Avdhoot87/Summer_Research_Internship_IITGN/README.md

# DESIGN_AND_DEVELOPMENT_OF_A_PORTABLE_UNIVERSAL_TESTING_MACHINE
