Avdhoot87/Summer_Research_Internship_IITGN/CAD MODEL FINAL DESIGN/UTM FINAL MODEL.step

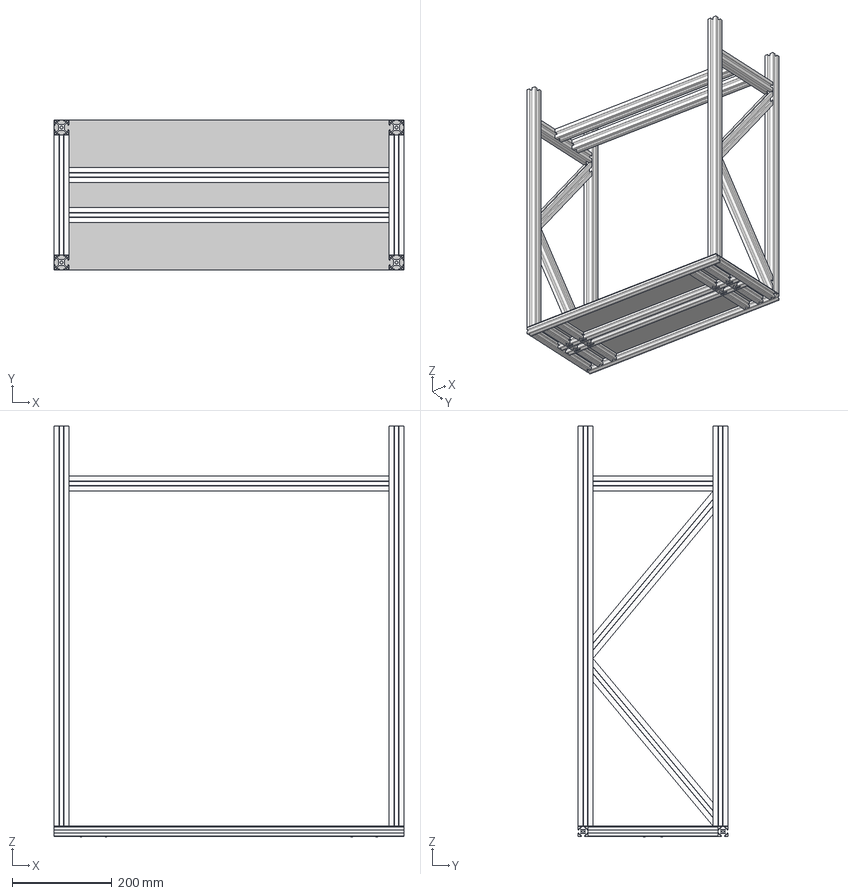
[picture p13: CAD file, 2026-09-14]
CAD MODEL FINAL DESIGN/UTM FINAL MODEL.step
700.0 x 300.0 x 822.0 mm
Steel Sheet
20 mm ROD 700 mm length x 2
20 mm ROD 260mm length x 6
20 mm ROD 660mm length x 2
800 mm Rod x 4
30x30 sketch x 2
640mm Rod x 2
KSHAPE+ROD x 4
