Avdhoot87/Summer_Research_Internship_IITGN/CAD MODEL FINAL DESIGN/UTM PARTS/LOAD CELL v1.step

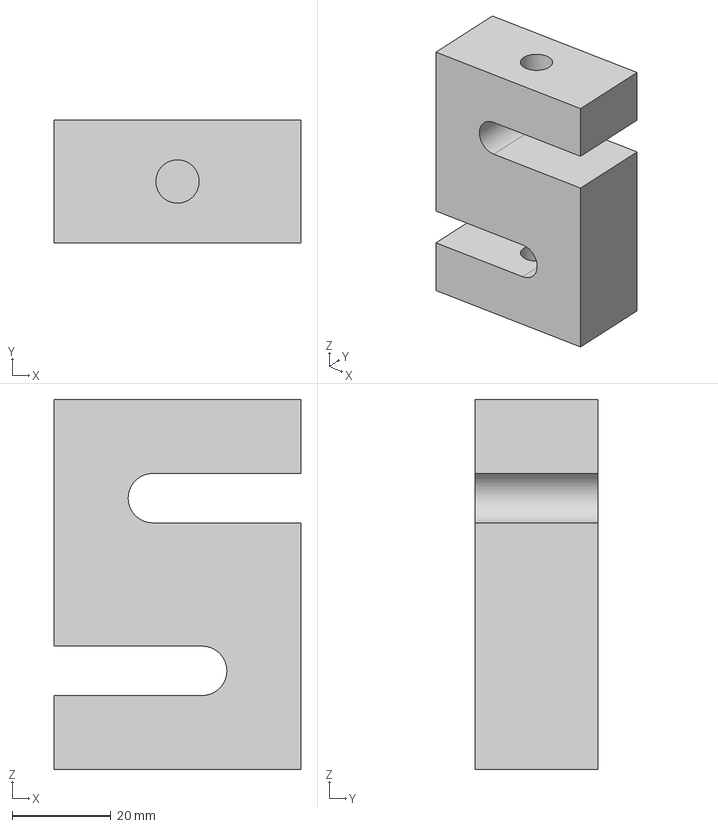
[picture p14: CAD file, 2026-09-14]
CAD MODEL FINAL DESIGN/UTM PARTS/LOAD CELL v1.step
50.0 x 25.0 x 75.0 mm
