Avdhoot87/Summer_Research_Internship_IITGN/CAD MODEL FINAL DESIGN/UTM PARTS/KSHAPE+ROD v1.step

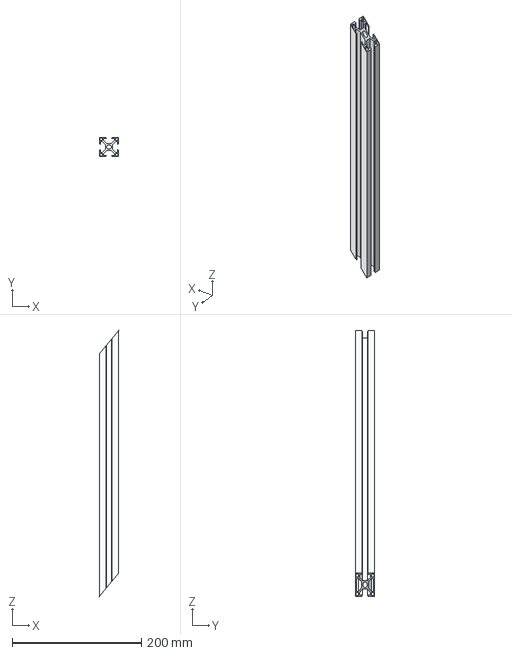
[picture p15: CAD file, 2026-09-14]
CAD MODEL FINAL DESIGN/UTM PARTS/KSHAPE+ROD v1.step
30.0 x 30.0 x 411.0 mm
