Avdhoot87/Summer_Research_Internship_IITGN/CAD MODEL FINAL DESIGN/UTM PARTS/Moving Crosshead along with load cell and load applier v1.step

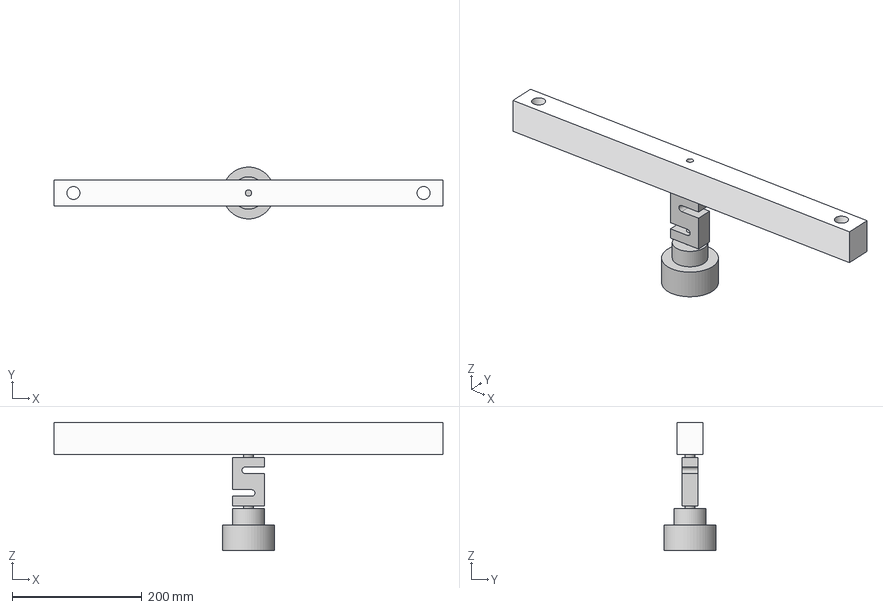
[picture p16: CAD file, 2026-09-14]
CAD MODEL FINAL DESIGN/UTM PARTS/Moving Crosshead along with load cell and load applier v1.step
600.0 x 80.0 x 198.0 mm
A_movecross
LOAD CELL JOINT NUT x 2
LOAD CELL_1
LOAD APPLIER
