Avdhoot87/Summer_Research_Internship_IITGN/CAD MODEL FINAL DESIGN/UTM PARTS/Steel Sheet v1.step

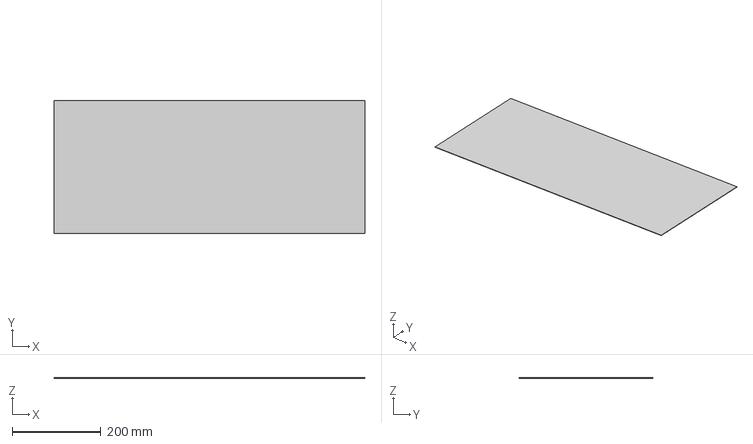
[picture p17: CAD file, 2026-09-14]
CAD MODEL FINAL DESIGN/UTM PARTS/Steel Sheet v1.step
700.0 x 300.0 x 1.00 mm
