Avdhoot87/Summer_Research_Internship_IITGN/CAD MODEL FINAL DESIGN/UTM PARTS/Thrust Bearing v1.step

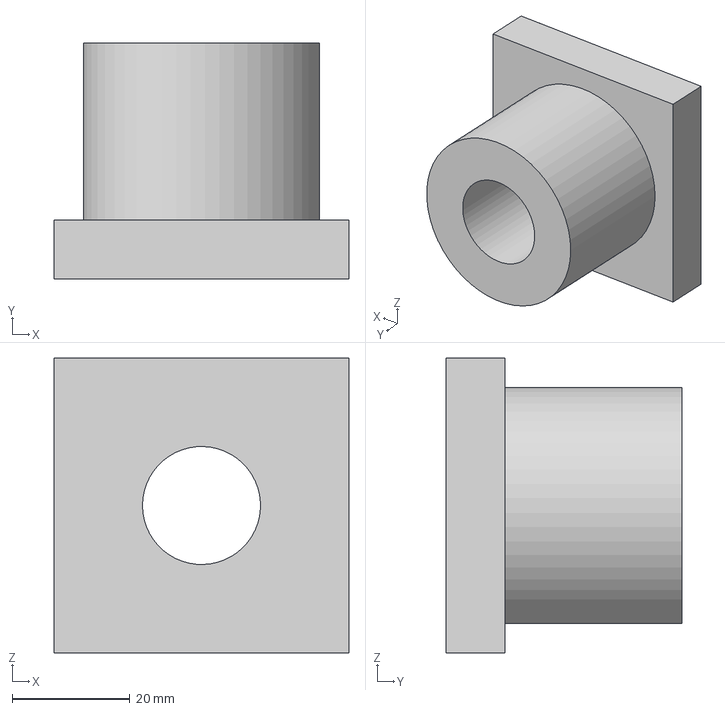
[picture p18: CAD file, 2026-09-14]
CAD MODEL FINAL DESIGN/UTM PARTS/Thrust Bearing v1.step
50.0 x 40.0 x 50.0 mm
