Avdhoot87/Summer_Research_Internship_IITGN/CAD MODEL FINAL DESIGN/UTM PARTS/240 mm rod v1.step

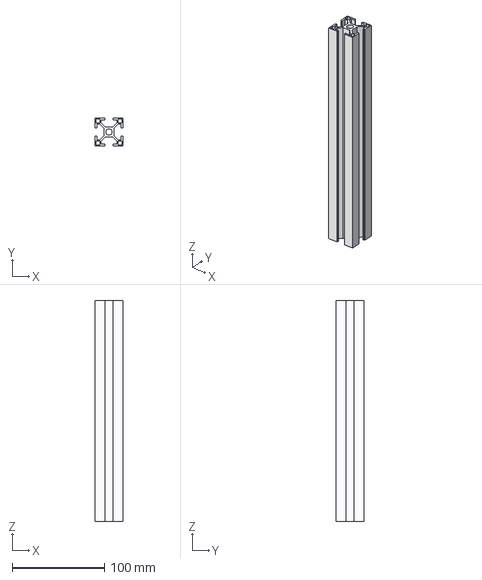
[picture p19: CAD file, 2026-09-14]
CAD MODEL FINAL DESIGN/UTM PARTS/240 mm rod v1.step
30.0 x 30.0 x 240.0 mm
