Avdhoot87/Summer_Research_Internship_IITGN/CAD MODEL FINAL DESIGN/UTM PARTS/20 mm ROD 700 mm length v1.step

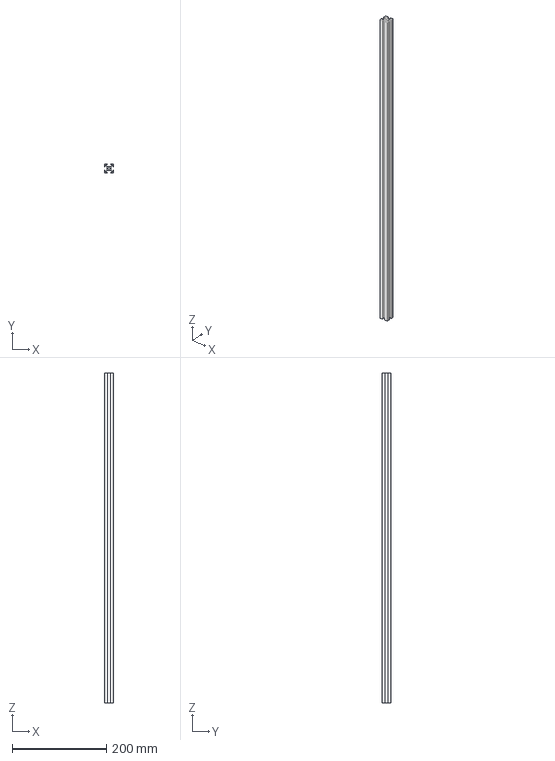
[picture p20: CAD file, 2026-09-14]
CAD MODEL FINAL DESIGN/UTM PARTS/20 mm ROD 700 mm length v1.step
20.0 x 20.0 x 700.0 mm
