Avdhoot87/Summer_Research_Internship_IITGN/CAD MODEL FINAL DESIGN/UTM PARTS/800 mm Rod v1.step

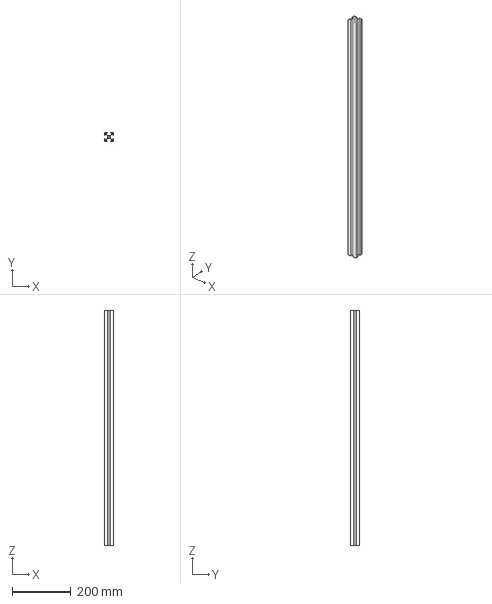
[picture p21: CAD file, 2026-09-14]
CAD MODEL FINAL DESIGN/UTM PARTS/800 mm Rod v1.step
30.0 x 30.0 x 800.0 mm
