Avdhoot87/Summer_Research_Internship_IITGN/CAD MODEL FINAL DESIGN/UTM PARTS/A_movecross v1.step

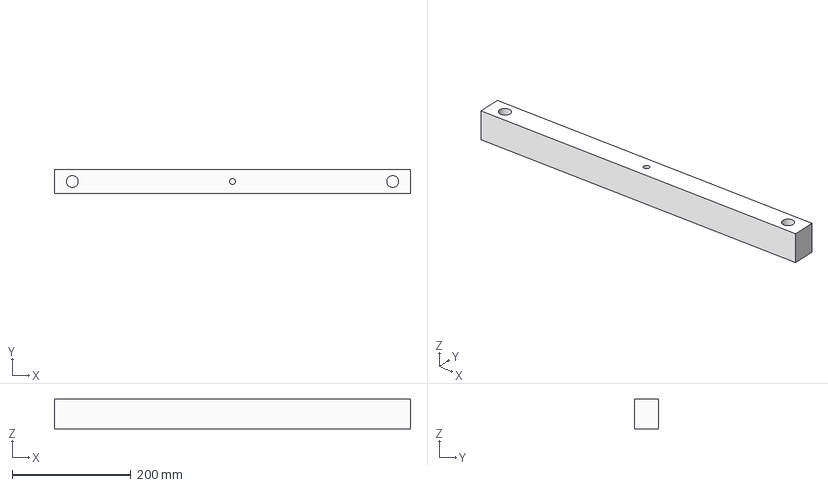
[picture p22: CAD file, 2026-09-14]
CAD MODEL FINAL DESIGN/UTM PARTS/A_movecross v1.step
600.0 x 40.0 x 50.0 mm
