Avdhoot87/Summer_Research_Internship_IITGN/CAD MODEL FINAL DESIGN/UTM PARTS/Final_Shaft 10mm-20mm v1.step

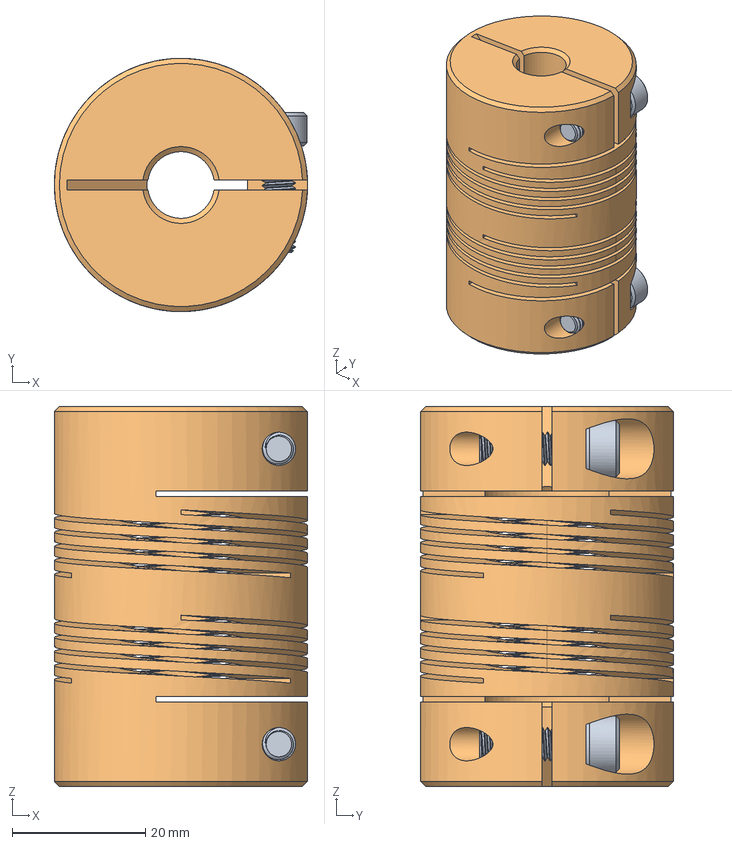
[picture p23: CAD file, 2026-09-14]
CAD MODEL FINAL DESIGN/UTM PARTS/Final_Shaft 10mm-20mm v1.step
38.0 x 38.0 x 57.0 mm
