Avdhoot87/Summer_Research_Internship_IITGN/CAD MODEL FINAL DESIGN/UTM PARTS/F_M_step_motor v1.step

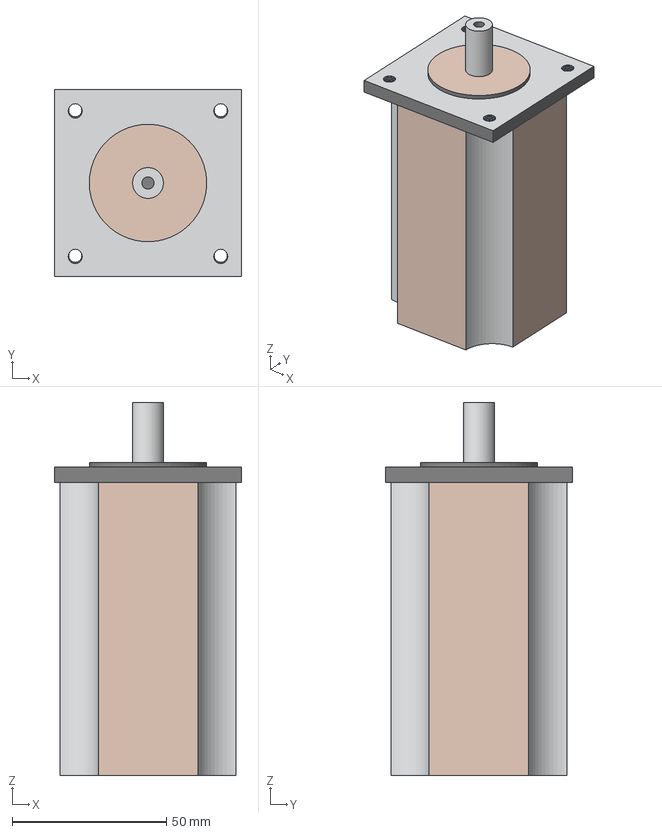
[picture p24: CAD file, 2026-09-14]
CAD MODEL FINAL DESIGN/UTM PARTS/F_M_step_motor v1.step
60.8 x 60.8 x 121.0 mm
