Avdhoot87/Summer_Research_Internship_IITGN/CAD MODEL FINAL DESIGN/UTM PARTS/20 mm ROD 260mm length v1.step

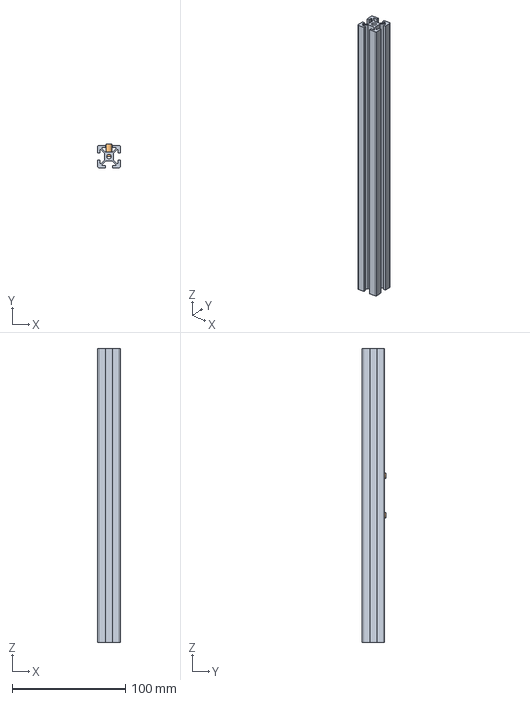
[picture p25: CAD file, 2026-09-14]
CAD MODEL FINAL DESIGN/UTM PARTS/20 mm ROD 260mm length v1.step
20.0 x 21.0 x 260.0 mm
