Avdhoot87/Summer_Research_Internship_IITGN/CAD MODEL FINAL DESIGN/UTM PARTS/Base 70cm x 30 cm v1.step

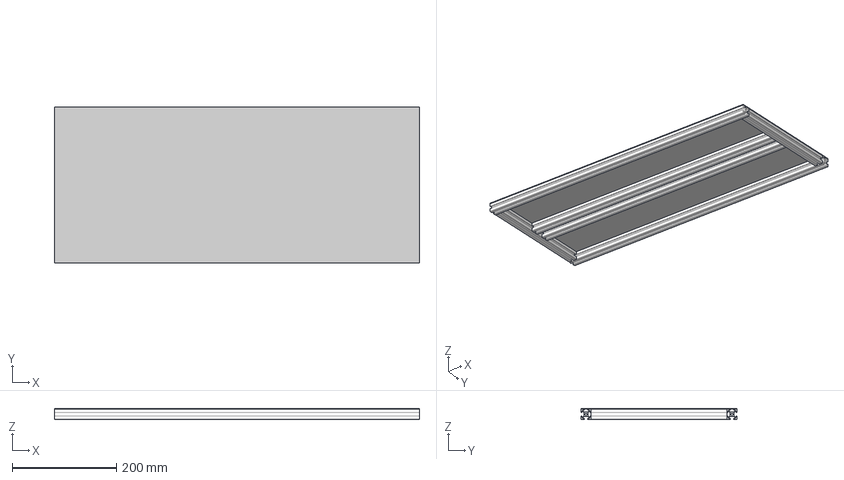
[picture p27: CAD file, 2026-09-14]
CAD MODEL FINAL DESIGN/UTM PARTS/Base 70cm x 30 cm v1.step
700.0 x 300.0 x 21.0 mm
Steel Sheet
20 mm ROD 700 mm length x 2
20 mm ROD 260mm length x 2
20 mm ROD 660mm length x 2
