Avdhoot87/Summer_Research_Internship_IITGN/CAD MODEL FINAL DESIGN/UTM PARTS/LOAD APPLIER v1.step

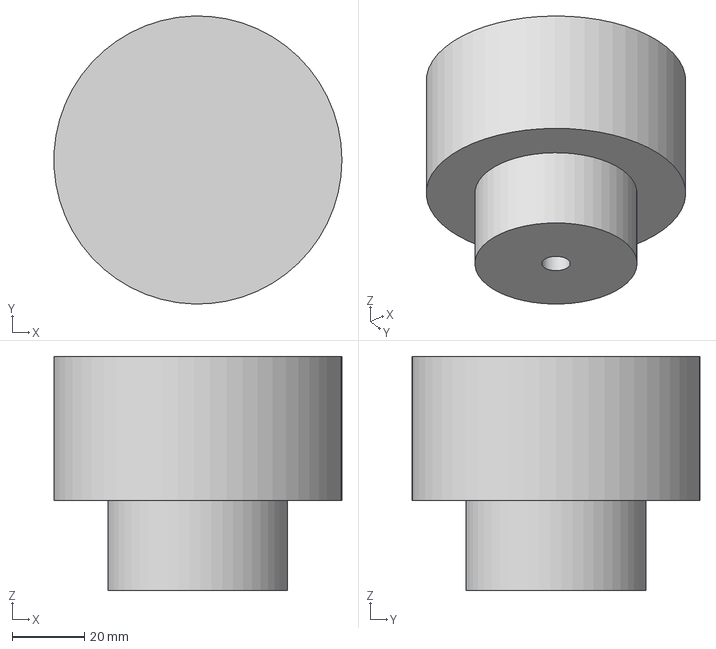
[picture p28: CAD file, 2026-09-14]
CAD MODEL FINAL DESIGN/UTM PARTS/LOAD APPLIER v1.step
79.9 x 80.0 x 65.0 mm
