Avdhoot87/Summer_Research_Internship_IITGN/(list of files, cad)

Other CAD files:
CAD MODEL FINAL DESIGN/UTM PARTS/Stepper Motor v1.step
CAD MODEL FINAL DESIGN/UTM PARTS/LOAD CELL JOINT NUT v1.step
CAD MODEL FINAL DESIGN/UTM PARTS/Lead Screw v1.step
